TheRealBolle/Performer-SE-PL-CL/(threads)

Thread 1 (2024-03-26):

Working model?

anarchopossum, 2024-03-26:
Hello I would like to ask if you have made a working model for this project?

TheRealBolle, 2024-03-28:
What do you mean? The recreated PCBs are confirmed to work just fine by several others as well as myself.

anarchopossum, 2024-03-29:
Sorry, I am completely new to hardware and was trying to find a project that I could to assemble to make a accelerator card for my Mac SE. I just wanted to know if your project was confirmed to work.

I asked a similar question in another person's repo and they referred to this project  instead.

Closed 2024-03-29.

Thread 2 (2024-11-08):

XTAL Voltage Compatibility, Overclock Limit, Half-CAN XTAL compatibility

JDW1, 2024-11-08:
Three points:

1. It would be helpful if the **required voltage** for the optional XTAL oscillator could be added to the README.

2. It would be nice if an upper clock speed limit for the FPU could be mentioned (when optional XTAL is used).  Is it 33MHz max?  Or is the only limit simply whatever the 68882 overclocks to?

3. In a future PCB revision, could two holes be added so that half-sized CAN oscillators could be used too?  (Consider how Daystar has 6 holes in the XTAL location on the Turbo040, which can accommodate either size of XTAL.)
